budulinek/arduino-modbus-rtu-tcp-gateway/(threads)

Thread 2 (2021-04-10):

adapt project for stm32

jmcastillejo, 2021-04-10:
I would like to know if it is possible to adapt this project for the stm32f103 "bluepill" or similar

budulinek, 2021-04-10:
I do not have bluepill at the moment, so I can not test it.

It should be possible, but you will need to do some changes to the code. See https://github.com/budulinek/arduino-modbus-rtu-tcp-gateway#portability

Also, check the bluepill pinout for serial connections (for RS485) and SPI connections (for ethernet shield).

Closed 2021-04-12.

Thread 3 (2021-04-12):

warning compilation

jmcastillejo, 2021-04-12:
Warning compiler for mega2560:

arduino-modbus-rtu-tcp-gateway\04-webserver.ino:288:20: warning: invalid conversion from 'byte {aka unsigned char}' to 'action_type' [-fpermissive]
           action = (byte)atoi(strtok_r(NULL, "=", &sav2));

budulinek, 2021-04-12:
Yes, I know.

In order to minimize the code size (so that it can fit Nano), I did a dirty trick with atoi() while parsing the "Tools" form values (buttons):

https://github.com/budulinek/arduino-modbus-rtu-tcp-gateway/blob/51595a10fe23155318b2775a49f6ef0d00921b43/arduino-modbus-rtu-tcp-gateway/04-webserver.ino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

I think it is save to ignore the warning, because the form values are fully under our control and can only have values 1, 2 and 3.
see https://github.com/budulinek/arduino-modbus-rtu-tcp-gateway/blob/51595a10fe23155318b2775a49f6ef0d00921b43/arduino-modbus-rtu-tcp-gateway/05-pages.ino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

Also, see comments in code:
https://github.com/budulinek/arduino-modbus-rtu-tcp-gateway/blob/51595a10fe23155318b2775a49f6ef0d00921b43/arduino-modbus-rtu-tcp-gateway/04-webserver.ino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

budulinek, 2021-04-12:
That did the trick :-)

Closed 2021-04-12.

Thread 5 (2021-04-13):

timeout error

jmcastillejo, 2021-04-13:
I have managed to make the project work on an arduino mega 2560, but the master simulator throws me timeout error in alternate reads, one ok and another reading timeout error and so on. that could be happening?

great job

budulinek, 2021-04-13:
Which master simulator do you use?

Do you have errors on both Modbus TCP and Modbus UDP?

What is your connection timeout on master? What is your timeout on Arduino?

Thanks.

jmcastillejo, 2021-04-14:
I use de radzio master simulator http://en.radzio.dxp.pl/modbus-master-simulator/

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

This softaware not support modbus udp. In arduino timeout set to 1000ms, although with other configurations it still fails the same

budulinek, 2021-04-14:
Thanks. Yes, I can reproduce the error. Modbus UDP is OK, so the problem is in the way I use TCP sockets...

jmcastillejo, 2021-04-19:
Do you have any solution?

tdcbyte, 2021-05-24:
I confirm the issue, also tested with arduino mega. UDP works fine, when using TCP, after the first request, the response is good, but second request is timed out en not send to the serial slave. The the third request is ok, the forth is not answered and so on...
I hope this can be fixed, still this project is really nice!

fumpel, 2021-06-03:
I think, I'm running into the same problem... I'm using the QModMaster. Behaviour is little different though: After opening a TCP connection the first request works fine, all subsequent requests don't. Reopening the connection again gives one working request.

fumpel, 2021-06-04:
Had a look at the code...
Could it be, that this line:
[https://github.com/budulinek/arduino-modbus-rtu-tcp-gateway/blob/16246c5eff7095fcb870da9db0f55f82c50b81ea/arduino-modbus-rtu-tcp-gateway/02-modbus-tcp.ino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](client.stop())
is the issue? Isn't this closing the TCP Connection after every received packet? Then the TCP Modbus Master would have to reestablish the connection after every packet... simple Modbus Masters won't do that.

budulinek, 2021-06-05:
Essentially there are two ways how to handle sockets:

First aproach:
https://www.arduino.cc/en/Tutorial/LibraryExamples/WebServer
`EthernetClient client = server.available();`

Second approach:
https://www.arduino.cc/en/Tutorial/LibraryExamples/AdvancedChatServer
you declare before setup:
`EthernetClient clients[8];`
and the inside loop (or some nested function):
```
EthernetClient newClient = server.accept();
  if (newClient) {
    for (byte i=0; i < 8; i++) {
      if (!clients[i]) {
        clients[i] = newClient;
        break;
      }
    }
  }
```

Originally, I used the second approach and everything worked fine. Then I switched to the first approach (to save some code) and it broke the TCP connections. Sockets get closed and I do not even know whether it is because of my code or the library.

I was busy at work so did not have time to look at it.
@fumpel I do not think removing this client.stop(); solves the issue.

budulinek, 2021-06-06:
@fumpel
Oh man, you were right. Removing all instances of  client.stop() solved the issue.

https://github.com/budulinek/arduino-modbus-rtu-tcp-gateway/commit/574c3cc78f476bb6d9bc1779059331fc5668aac1

We do not need client.stop(), because the server.available() function should take care of this (it should close connection if the remote hos closes the connection).

If the problem reappears, let me know.

SuriyaStar123, 2021-12-20:
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

How to get off this error and write numbers in 0 and check with modscan

Closed 2021-06-06.

Thread 6 (2021-05-03):

Run this Gateway on a ESP8266

turti83, 2021-05-03:
I am new on github and dont know how to ask a questions like this way. Is this the right way?
This project is exactly what i was looking for. However, I would like to run it on an ESP8266. Is it possible without a lot of changes, or does it take a lot of effort to run it on the esp?
certainly the following line must be inserted:
#include <ESP8266WiFi.h>
and removed this:
#include <utility/w5100.h>

budulinek, 2021-06-06:
Sorry, but I do have no experience with ESP8266.
There is some code which is specific to Arduino (see https://github.com/budulinek/arduino-modbus-rtu-tcp-gateway#portability). So some modifications are needed.
Feel free to fork my repository and modify the code for ESP8266.

harihanv, 2021-07-14:
https://github.com/harihanv/esp32-modbus-gateway, trying to port on esp32

ayaser, 2021-12-27:
Nice to meet you. first congratulations for your contribution. I have several doubts, one of them is the same as the one made by Turti83, how to use these codes in ESP8266, and I clearly saw that your answer is that you have not developed it on this platform.
The other question I have is that there are several ino files in the folder, and the question I have is whether each of these can be loaded on the platform that one would like independently. That is, if I want the Slave to work in an Arduino (1), how do I load only the Slave, if I want the Master to work in the Arduino (2), how do I do it?
I have the problem because when compiling, it does it mostly the innocent. Please could you explain.

budulinek, 2021-12-27:
Hi ayaser,
the code was made for AVR Arduino. There is some AVR-specific codec (see Readme). Maybe, after removing / changing that piece of code, it would be possible to run it on ESP8266 or ESP32. But I do not know, I do not have ESP8266 or ESP32, so I can not test it.  You can try this port:
https://github.com/harihanv/esp32-modbus-gateway

The code is quite long, I have divided it into several ino files. You need all ino files in the folder to compile the code.

ayaser, 2021-12-27:
muchas gracias por tu respuesta.

Adrián Yaser

***@***.***
+56 9 6149 8858 <https://api.whatsapp.com/send?phone=+56961498858>

DVRSOLUTIONS
Servicios y Productos para su Seguridad
<https://api.whatsapp.com/send?phone=+56961498858>

El lun, 27 dic 2021 a la(s) 13:59, budulinek ***@***.***)
escribió:

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

budulinek, 2021-12-27:
BTW, @harihanv was able to run it on ESP32, but his code is obsolete - he did not fork from my repo but created new one  :-(

Please fork the repo and if you (or anyone else) is successful in porting to ESP32 / ESP8266, feel free to do a pull request. I would be happy to include it.

ayaser, 2021-12-27:
Thank you very much for your answer
The five programs are united in the first one, is correct what I say? those
are not 5 standalone programs.
Therefore, everything would be loaded on the arduino board and then through
the web I would choose which function it would fulfill.
what i said is correct?

El lun., 27 de diciembre de 2021 2:40 p. m., budulinek <
***@***.***> escribió:

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

harihanv, 2021-12-28:
hi,

 I am sorry for the late reply. I was trying to implement RTU to TCP modbus
gateway. This is more of packet translation
that was the reason i used the code available and ported to esp32.

From your description looks like you need modbus slave / master for your
implementation. We can either port libmodbus
or freemodbus to esp8266.

I will check on nodemcu and update.

Regards,
Harish

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

ayaser, 2021-12-28:
Sorry, my English is not the best, and I think I got a little lost in the
thread of the conversation, I don't know if all the emails were yours, or
if another person intervened commenting on ESP8266.

First of all, thanks again for your answer.
The project that you wrote is just what I need, that is why I attached a
file in pptx in case you want to modify it or rather correct it.
It is about implementing Modbus, a slave in which I can execute certain
programs, a Master which can give setting values to the Slave, and a
Gateway that allows me to send the parameters to Modbus and deliver its
results to the user, which could be both an operator like the manager.

I am an electronic engineer, I am not an expert in programming, and I am
trying to make a technology integration system, I do not intend to invent
anything, but to develop a system that I can implement to sell and earn
money.
I want to clarify this because I am not an expert in open systems, so I do
not know what is the scope of what I can expect from this type of
contribution, which I see as extraordinary. What I mean is that if your
time had a cost, I am not in a position to pay it now, but if the economic
result were advantageous, I would have no problem sharing it.

Using the translator, I can know if the phrase in English is correct, if
they express what I want to convey to you.
If you have any possibility of being able to do a chat (written), it would
be good if we could talk, logically if you have time.

I am in Chile, with time zone -3.

My cell phone is +56961498858.
Kind regards.

Adrián Yaser

***@***.***
+56 9 6149 8858 <https://api.whatsapp.com/send?phone=+56961498858>

DVRSOLUTIONS
Servicios y Productos para su Seguridad
<https://api.whatsapp.com/send?phone=+56961498858>

El mar, 28 dic 2021 a la(s) 01:26, harihanv ***@***.***)
escribió:

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

harihanv, 2021-12-28:
Request to attach the ppt again. I have taken code from the author who
replied previously; removed ethernet code and added wifi.

If you are looking it to work on esp8266, I need to check on serial port
availability.

Regards,
Harish

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

ayaser, 2021-12-28:
I apologize. I did not understand his answer.

Adrián Yaser

***@***.***
+56 9 6149 8858 <https://api.whatsapp.com/send?phone=+56961498858>

DVRSOLUTIONS
Servicios y Productos para su Seguridad
<https://api.whatsapp.com/send?phone=+56961498858>

El mar, 28 dic 2021 a la(s) 06:50, harihanv ***@***.***)
escribió:

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

harihanv, 2021-12-28:
Please share the ppt

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

Thread 7 (2021-09-01):

The connection to the Modbus master is broken after a few hours

dl9msr, 2021-09-01:
Hardware:
Arduino Mega 2560, W5500 lite, 1 RTU Slave 0x01
Modbus Mode : Modbus TCP/UDP

Modbus Master TCP/502, query interval 120s ,timeout 5s

The connection to the web interface TCP/80 also breaks off.
After pressing the reset button, the connection is re-established

budulinek, 2021-09-01:
Only TCP connections break down? UDP packets and ping still working?

At the moment I use Modbus UDP (without problems), but I will switch to Modbus TCP and try to reproduce.

dl9msr, 2021-09-02:
I have only TCP connections.

Ping also don’t work

I tried to use the library

ethernet2.h

utility/w5500.h

but I got compiler failer

best regards

Michael

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

budulinek, 2021-09-04:
So I have been using both Modbus UDP and Modbus TCP  (simultaneously) for 2 days, no problem with the connection.

Arduino Nano + W5500 (8 sockets) + RS485 module with HW flow control. Modbus UDP query interval 1s, Modbus TCP query interval 5s.

If you are willing to do further tests, here are my suggestions:

1. Stress test TCP connection.

Enable per socket diagnostics https://github.com/budulinek/arduino-modbus-rtu-tcp-gateway/blob/3a9afdfba7689f2c079b421252b8db301b681e2b/arduino-modbus-rtu-tcp-gateway/arduino-modbus-rtu-tcp-gatew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

Use https://packetsender.com/ to test TCP (or UDP) connections. If you send Modbus TCP message (with correctly formated header) to the gateway, you will get a response (either a message with Modbus data, or a message with a Modbus error). You can try for example HEX: 00 01 00 00 00 06 01 04 00 00 00 01

Try both TCP and UDP.

Then you can set "Resend delay" to some low value, such as 0.1s and start sending TCP data periodically. This is the stress test (DoS) to the gateway. If the "Resend delay" is low enough, all sockets available on your ethernet module will quickly fill (you can see the status of all sockets it in the status web page of the gateway) and you will get connection errors (in Packet Sender and maybe also your web browser). If you stop the stress test, Arduino should gradually free up some sockets and everything should get to normal.
If the TCP stress test is successful (= if Arduino correctly recovers sockets once you stop the stress test), you know that TCP socket allocation (and recovery) works correctly.

2. Disable Web UI.

You can try to disable parts of the code (functionality) within the sketch and see if the problem with Modbus TCP connection persists. As the first step, you can disable Web UI by commenting out these lines:

https://github.com/budulinek/arduino-modbus-rtu-tcp-gateway/blob/3a9afdfba7689f2c079b421252b8db301b681e2b/arduino-modbus-rtu-tcp-gateway/04-webserver.ino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
https://github.com/budulinek/arduino-modbus-rtu-tcp-gateway/blob/3a9afdfba7689f2c079b421252b8db301b681e2b/arduino-modbus-rtu-tcp-gateway/04-webserver.ino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
https://github.com/budulinek/arduino-modbus-rtu-tcp-gateway/blob/3a9afdfba7689f2c079b421252b8db301b681e2b/arduino-modbus-rtu-tcp-gateway/04-webserver.ino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

There is a lot of code responsible for the Web UI and I did found some bugs over there in the past. PLS let me know if disabling Web UI helped or not.

P.S. ethernet2.h won't compile since I use some functions which are only available in default ethernet.h library

dl9msr, 2021-09-05:
So I did the stress test and everything works as you wrote.

Now I disabled the Web UI by commenting out these lines:
`111 //      sendPage(client, 0xFF);                                 // Send "please wait" page

140  //    sendPage(client, reqPage);
141  //   else if (!strcmp(uri, "/favicon.ico"))     // a favicon
142  //     send204(client);                         // if you don't have a favicon, send 204
143 //    else                                       // if the page is unknown, HTTP response code 404
`
I will then come back with the result

dl9msr, 2021-09-07:
So I have been testing ModbusTCP for 2 days and have no problems with the connection.
WEb UI current status active all the time
Extra_Diag enabled
other Web UI commented out
Modbus/Master Settings for the test:
read interval 10s
timeout 10s

budulinek, 2021-09-07:
Thanks for debugging!

OK, so it seems that the bug is somewhere in 05-pages.ino

We also know that status page (i.e. reqPage == 1 ) works OK.

If you are willing to proceed here are my suggestions.

Reverse your previous comments you made in 04-webserver.ino, we will focus on 05-pages.ino

Comment out references to functions responsible for other pages:
https://github.com/budulinek/arduino-modbus-rtu-tcp-gateway/blob/3a9afdfba7689f2c079b421252b8db301b681e2b/arduino-modbus-rtu-tcp-gateway/05-pages.ino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
https://github.com/budulinek/arduino-modbus-rtu-tcp-gateway/blob/3a9afdfba7689f2c079b421252b8db301b681e2b/arduino-modbus-rtu-tcp-gateway/05-pages.ino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
https://github.com/budulinek/arduino-modbus-rtu-tcp-gateway/blob/3a9afdfba7689f2c079b421252b8db301b681e2b/arduino-modbus-rtu-tcp-gateway/05-pages.ino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
https://github.com/budulinek/arduino-modbus-rtu-tcp-gateway/blob/3a9afdfba7689f2c079b421252b8db301b681e2b/arduino-modbus-rtu-tcp-gateway/05-pages.ino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

You may also comment out the code responsible for autorefresh (lines 43-49)
  if (reqPage == 1 || reqPage == 0xFF) page.print(F(" http-equiv=refresh content=5"));
  if (reqPage == 0xFF) {
    page.print(F(";url=http://"));
    page.print((IPAddress)localConfig.ip);
    page.print(F(":"));
    page.print(localConfig.webPort);
  }

If there are no problems with connection, you can enable pages one after another in order to catch the bug.

Hmm, you know what? I have a suspicion that this line could be the cause of the bug:

https://github.com/budulinek/arduino-modbus-rtu-tcp-gateway/blob/3a9afdfba7689f2c079b421252b8db301b681e2b/arduino-modbus-rtu-tcp-gateway/05-pages.ino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

change it to

content.print((IPAddress)defaultConfig.ip);

defaultConfig.ip already is IPAddress type,  so we probably do not need to use the (IPAddress) cast. But see

https://github.com/budulinek/arduino-modbus-rtu-tcp-gateway/blob/3a9afdfba7689f2c079b421252b8db301b681e2b/arduino-modbus-rtu-tcp-gateway/05-pages.ino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

where I had to use the (IPAddress) cast. Do not know why, but without the cast, line 46 caused Arduino freezing.

dl9msr, 2021-09-08:
Thank you for response.
I started the test with the change in line 544

dl9msr, 2021-09-10:
That seems to be the bug.
The test has been running for 48 hours without any problems.
Many thanks for your help.

budulinek, 2021-09-10:
Great to hear that!

Thanks for hunting the bug!

Closed 2021-09-10.

Thread 10 (2021-11-15):

the last version doesn't work well

dl9msr, 2021-11-15:
Hello,
the last version v3.0 doesn't work well.
The connection freezes after a few minutes and I have to reset the Arduiono.
Troubleshooting from last issue didn't help
I'm back to version v2.3

Best regards
Michael

budulinek, 2021-11-15:
Hi,
thanks for your report.

My Arduino is fine at the moment. In version 3.0 I have increased webOutBufferSize from 64 bytes to 128 bytes in order to speed up web UI loading. I thought the step is safe... Could you PLS try to go back to 64 bytes and check whether it helps?

https://github.com/budulinek/arduino-modbus-rtu-tcp-gateway/blob/ac497050e0fdd2a4397ac155dacb7308a479f9c6/arduino-modbus-rtu-tcp-gateway/05-pages.ino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

dl9msr, 2021-11-15:
Hi,

thank you for your prompt reply. I have changed to 64byte.
I'll get back to you tomorrow

Good night.

Michael

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

dl9msr, 2021-11-16:
Hello,
I think the problem is my Arduino Mega 2560 on the test board and not your sketch.  I have to take a closer look at that.

I loaded the sketch in the production system with the Arduino Mega 2560 R3 pro mini and it works fine there.

Thanks for your support

budulinek, 2021-11-16:
OK.

Closed 2021-11-16.

Thread 11 (2021-11-23):

Modbus RTU Slave ID in Modbus TCP/UDP not function

lilisugeng, 2021-11-23:
When using Modbus TCP/UDP the scanned modbus RTU Slave ID may not be stored permanently, causing the master to fail to connect.

budulinek, 2021-11-23:
This is a feature (of all Modbus Gateways), not a bug. It is up to the master to remember the correct slave ID. It is also up to the master to send correctly formated Modbus TCP message (which contains slave ID).

Does the "Scan" button find your RTU slave? It means that RTU slave sent a response to a test command sent by the gateway. It means that your RTU settings are correct.
Does RTU slave disappear from the "Current Status" page once you connect your master to the gateway? It means that:

- gateway accepted your Modbus TCP message from the master and forwarded it to the RS485 line
- RTU slave did not respond (maybe because the master used wrong slave ID) or responded with an error

PLS check the Modbus TCP message sent by the master.

lilisugeng, 2021-11-23:
The scan button finds the Slave RTU, in this case it finds 0x01 OK, that's also the Slave ID I set on the master.
I'm using a kepware OPC server for this test and I'm using a Schneider PM800 Energy Meter.
The gateway works fine when I use Modbus over TCP, with the same Slave ID setting, but not for Modbus TCP.  Is there anything I should pay more attention to? Thanks

lilisugeng, 2021-11-23:
Sory I think I did wrong in my kepware setup, I use modbus scanner it is working fine also when I use Modbus TCP.
Sorry again for my foolness.
Thanks so much,  the program you have made is realy awsome.  Thank you.

budulinek, 2021-11-23:
Hi, I am glad to hear that everything works :-) Be careful, Modbus TCP and Modbus RTU over TCP are two different things.
Have a nice day!

Closed 2021-11-23.

Thread 16 (2022-05-08):

Esp32 version

maufc, 2022-05-08:
Hi
I am trying to make this work on esp32. There are some fork version for esp32 but no one works, at least for esp32 dev board.
Would it be so complicated to adapt this to esp8266/esp32?
I think the memory limits on Arduino borads will be overcome.
The main problem seems to be in ArduinoRS485.h with SERIAL_PORT_HARDWARE variable definition.
Thanks!

hopfi2k, 2022-05-08:
Same here. Maybe https://github.com/plerup/espsoftwareserial/ is the way?
Thanks

budulinek, 2022-05-08:
I do not use ArduinoRS485.h (too big, not needed)!!!! I use Arduino HW serial for the communication with the RS485 module. Since ESP32 also has HW serial ports, modifying my gateway for ESP32 should be easy. I have no experience with ESP32, but I think all you need to do is:

1. replace the Ethernet.h with Wifi.h library and adjust the code accordingly (some functions may be missing in Wifi.h library)
2. use HW serial port on ESP32 (see https://circuits4you.com/2018/12/31/esp32-hardware-serial2-example/ )
3. find an alternative to these Arduino-specific libraries and functions:

https://github.com/budulinek/arduino-modbus-rtu-tcp-gateway/blob/5ee77b5b54f74b51e5f2c49246ac2ff60f4e7cb6/arduino-modbus-rtu-tcp-gateway/arduino-modbus-rtu-tcp-gatew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

https://github.com/budulinek/arduino-modbus-rtu-tcp-gateway/blob/5ee77b5b54f74b51e5f2c49246ac2ff60f4e7cb6/arduino-modbus-rtu-tcp-gateway/01-interfaces.ino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

https://github.com/budulinek/arduino-modbus-rtu-tcp-gateway/blob/5ee77b5b54f74b51e5f2c49246ac2ff60f4e7cb6/arduino-modbus-rtu-tcp-gateway/01-interfaces.ino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

I use these functions for generating random MAC and for reseting Arduino via Web UI. These are not core functions, you can easily modify the code to use static MAC and drop the function for reseting Arduino....

I know there is a ESP32 port here: https://github.com/harihanv/esp32-modbus-gateway
But it takes the wrong approach by using the ArduinoRS485.h library. As I have already said, forget about ArduinoRS485.h and use HW serial on your ESP32!

Once you have it running, let me know (or do a pull-request) and I would be happy to adjust my code to make it ESP32 compatible.

zivillian, 2022-06-12:
I've started a port, but it's still work in progress. It compiles, the web ui works (sometimes) but there are still many things to to. The current state is available at https://github.com/zivillian/arduino-modbus-rtu-tcp-gateway/tree/esp32

maufc, 2022-06-12:
Looks great!
I'll try this week and let you know!

zivillian, 2022-06-14:
I have to admit, that I gave up and started from scratch with ESP32 libraries. It's far from finished and there's no usable webinterface yet, but the modbus RTU/TCP stuff is already working. If anyone is interested and want's to help - my code is available at https://github.com/zivillian/esp32-modbus-gateway

zivillian, 2022-06-17:
It may not (yet) have all features, but I think I've reached the point where it's usable - if anyone is interested, there is also prebuilt binary to try out.

sefaguntepe, 2023-02-09:
Hello, I want to try the codes. Can you share the file for Arduino IDE?

sefaguntepe, 2023-02-10:
> It may not (yet) have all features, but I think I've reached the point where it's usable - if anyone is interested, there is also prebuilt binary to try out.

Hello, I want to try the codes. Can you share the file for Arduino IDE?

zivillian, 2023-02-10:
@sefaguntepe you can find the code at https://github.com/zivillian/esp32-modbus-gateway There is no file for Arduino IDE, because it's a platformio project. If you don't want to compile it yourself, you can try the binary from the release.

chuc2rk, 2024-08-05:
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

How about edit run on esp32 with W5500?
Thanks!

Thread 17 (2022-05-18):

exceeds available space in board in arduino nano

lilisugeng, 2022-05-18:
Dear Budulinek
I'm failed to build this project with arduino nano and its W5500 ethernet shield (RobotDyn). When I try to verify the program there is a message saying  exceeds available space in board.
But I thing you sucsess with the same hardware.  Please let me know if I did wrong.

Thanks

KjellVerb, 2022-05-21:
Probably due to some library updates... You can comment out the parts that generate a random MAC address and assign a static one, you'll be at 99%.

budulinek, 2022-05-21:
> Probably due to some library updates... You can comment out the parts that generate a random MAC address and assign a static one, you'll be at 99%.

Most probably (did not check yet). On Nano, there were just few bytes left. A library update may add few bytes, causing the issue you mention.

As suggested, try to comment out some code you do not need (random MAC, or some code in the webserver).

KjellVerb, 2022-05-21:
Yeah I started testing with the gateway on a nano yesterday (thanks for sharing your work btw!) and had the same issue, I can confirm that fixed Mac gets you below the threshold.

I'm now trying to get fixed RS485 settings with DHCP enabled because that fits my usecase better. Will fork if it works.

budulinek, 2022-05-21:
DHCP enabled on Nano? As far as I remember, DHCP enabled (dynamic IP) takes a lot of memory... Would require some drastic cuts to the code.

KjellVerb, 2022-05-21:
I'm OK with removing the entire webserver (drastic cuts indeed), I only need a static config with DHCP so that I can assign the IP address from my IOT router.

FYI: removing the webserver and enabling DHCP gets me to 74%, re-enabling random MAC address to 75%

budulinek, 2022-06-04:
Wow, some library got really hungry :-(   A library update (probably StreamLib) eating additional 200 bytes of precious flash....

I did my best to reduce the footprint of the program, I am at the end of my abilities.....

- Do you guys have any suggestions for further code optimisation?
- Any suggestions for which feature to remove from the default version of the sketch?

budulinek, 2022-06-04:
OK, I have removed ethernet data counter feature on the status page. If you need ethernet data counter, #define ENABLE_EXTRA_DIAG.
Now the program fits on Arduino Nano (tested 4.6.2022, Arduino IDE 1.8.19).

Closed 2022-06-04.

Thread 19 (2022-09-23):

Compiling Error

Honk815, 2022-09-23:
Hi budulinek,

great work. So I have an issue that I cannot solve. Maybe there is a library missing, but which? Error Code from Arduino IDE is attached. Thank you very much.

Nico
[error.txt](https://github.com/budulinek/arduino-modbus-rtu-tcp-gateway/files/9636570/error.txt)

budulinek, 2022-09-25:
It seems you did not properly download the INO files. Go to the main page https://github.com/budulinek/arduino-modbus-rtu-tcp-gateway
Code > Download ZIP

Unzip and open arduino-modbus-rtu-tcp-gateway.ino in Arduino IDE. Arduino IDE will automatically recognize other INO files (you will see them in separate tabs). Compile, upload and have fun!

Honk815, 2022-09-27:
Thank you very much, this solved the problems. I have downloaded the recommendet zip file.This is not ne reduced Code for nano, isn't it? I have got an error while compiling. "Program is too big for arduino nano" something like that. Thanks for help 😊
-------- Ursprüngliche Nachricht --------Von: budulinek ***@***.***> Datum: 25.09.22  23:34  (GMT+01:00) An: budulinek/arduino-modbus-rtu-tcp-gateway ***@***.***> Cc: Honk815 ***@***.***>, Author ***@***.***> Betreff: Re: [budulinek/arduino-modbus-rtu-tcp-gateway] Compiling Error (Issue #19)
It seems you did not properly download the INO files. Go to the main page https://github.com/budulinek/arduino-modbus-rtu-tcp-gateway
Code > Download ZIP
Unzip and open arduino-modbus-rtu-tcp-gateway.ino in Arduino IDE. Arduino IDE will automatically recognize other INO files (you will see them in separate tabs). Compile, upload and have fun!

—Reply to this email directly, view it on GitHub, or unsubscribe.You are receiving this because you authored the thread.Message ID: ***@***.***>

budulinek, 2022-09-28:
You are right, program too big. There was an update to Ethernet library in July and the library got bigger.

I will try to reduce the size of the code, but it may take me some time.

Honk815, 2022-09-29:
Thank very much! So I'am waiting for :-)
Like to reed out my PV inverter via modbus :)

budulinek, 2023-01-05:
Fixed!

Closed 2023-01-05.

Thread 21 (2023-02-27):

"Unknown board"

Hypercubo, 2023-02-27:
Hello, I have a problem with the code does not recognize the board. The model I have is the "atmega328p Xplained mini".

Error is:
287 #error "Unknown board"

Can anyone tellme, how fix it?

My configuration is:
Board: atmega328p Xplained mini (the hardware is same to serie NANO)
Ethernet: ENC28J60 (NANO Ethernet Shield v1.0 "Deek-Robot")
Modbus: MAX485

best Regards.

budulinek, 2023-02-27:
Sorry, ENC28J60 Ethernet chip is not supported. This is a very primitive chip, requires too much code to operate.

Please look for W5100, W5200 or W5500 Ethernet chips.

Hypercubo, 2023-02-27:
Very appreciate your answer, I'm going to follow your suggestion and I'm going to buy one of the chips you've indicated.
But i think the problem is other, because the error is come when i compile the software.

:(

budulinek, 2023-02-27:
It is not an error, only a warning generated here:

https://github.com/budulinek/arduino-modbus-rtu-tcp-gateway/blob/e9b04e0782aadbde82b311b4e275445ba4986fb9/arduino-modbus-rtu-tcp-gateway/01-interfaces.ino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

The board you use is unknown, but the code will still compile.

Hypercubo, 2023-02-27:
Ok, ty, i´m try it again when is arrived new ethernet shield.

budulinek, 2023-02-27:
You were right. The #error directive prevented compilation.
Fixed https://github.com/budulinek/arduino-modbus-rtu-tcp-gateway/commit/4bdf86b5f0abef4667fef429939ebc155f7168a5

Closed 2023-02-27.

Thread 24 (2023-04-19):

Trouble porting to STM32 Arduino

completehvac, 2023-04-19:
I am having some trouble getting this to work on STM32, have you tried this? I am using W5500 and get odd results when using the library functions such as W5100.readSnPORT(dataAvailable) this function.

If I assign it to a variable like this
uint8_t SnPORT = W5100.readSnPORT(dataAvailable); and then compare
if (SnPORT == 80) it works, but

if (W5100.readSnPORT(dataAvailable) == 80) gives incorrect results.

I think it might be a timing issue, but I cannot get it to work! I have tried a basic webserver with the hardware configuration and it works without issue. The only changes from your latest version is that I remove the generateuniqueID and hard code a mac address for testing.

budulinek, 2023-04-19:
Hi,
thanks for testing STM32 + W5500! I have not tried it myself.

My suspicion is wrong data type (cast). As far as I remember, W5100.readSnPORT() is uint16_t. Maybe `if (W5100.readSnPORT(dataAvailable) == 80)` fails because you are comparing different data types? Try to force uint16_t on the constant? Maybe `uint16_t(80)`?

if you use uint16_t in:
`uint16_t SnPORT = W5100.readSnPORT(dataAvailable);` and then compare
`if (SnPORT == 80)`, will it still work??

Also, at the moment I use `byte` and `unsigned int` data types. It would be a good idea to replace them with `uint8_t` and `uint16_t`.

completehvac, 2023-04-19:
Thanks for your reply, I tested and that want the issue, the cause was that I was reading the client port which for some reason reset the SnPORT to 0x00. That part now works, now I have other issues to find..
Thanks for your help.

Closed 2023-08-22.

Thread 32 (2023-12-12):

Arduino OPTA port

patkepa, 2023-12-12:
Hello!
I'm interested in porting this project to the Arduino OPTA(STM32H747XI)
Are there any suggestions  in regards to replacing the Atmega based code of this project, for STM32?

Thanks!

budulinek, 2024-01-14:
What ethernet chip is used in Arduino OPTA? Which ethernet chip do you want to use with STM32?

The code is tailor-made for the Wiznet W5100/W5200/W5500 ethernet chip. It would be very difficult to "port" the code to different ethernet chip.

papercodeIN, 2024-06-03:
Hi Creator,

Could you guide me how to implement this in wiznet w5100s-evb-pico (Raspberry Pi Pico) ?

budulinek, 2024-06-03:
> Hi Creator,
>
> Could you guide me how to implement this in wiznet w5100s-evb-pico (Raspberry Pi Pico) ?

I have no idea on how to port it to RPi. Some functions and libraries used by this project are specific to W5X00 ethernet chips (Ethernet.h library), some functions I use are specific to ATmega chips (random number generator, reset function, also probably the Serial library...).

Disclosure: I am a 100% hobbyist coder with no formal coding education. I made this gateway for fun and for my self-education. A kind of challenge - what else can I fit into a very limited flash and RAM resources of the ATmega chip. I did not and do not have an intention to port this project to bigger and more powerful platforms.

Closed 2024-11-05.

Thread 33 (2024-07-25):

Ethernet Shield 2 isn't operate

LiquidOcelot29, 2024-07-25:
Hello everyone,

I want to try this project on my Arduino Uno R3 with an Ethernet Shield 2 (W5500 chip). I'm using newest Arduino IDE (2.3.2 version) and libraries: Ethernet (2.0.2), CircularBuffer (1.4.0) and StreamLib (1.4.0) up to date.
Compiling and uploading the sketch to Arduino was successful, without any errors, Tx diode blinking at some time, so I guess program is running.
Unfournately I cannot reach web server, Modbus Poll can't connect and ping 192.168.1.254 adress ends with failure.
I reject that Arduino board and/or Ethernet Shield might be broken, because I uploaded Ethernet->Webserver, then I was able to ping Arduino and succesfully open website (192.168.1.177 as in sketch).

Sorry for my poor description, but that's all what I can do and if is missing something I'm gonna fill that.

Any advice what is could be and how to solve it?

LiquidOcelot29, 2024-07-26:
Okay, I don't know what the heck is going on, but I decided to try 6.0 version and it was working fine... o.O
Then I tried each successive version of the releases and also works well, even the latest (7.3). So I guess that this issue is to close

Closed 2024-07-26.

Thread 34 (2024-11-01):

TCP to RTU gateway

vitucciog, 2024-11-01:
Hi,
I have exactly the opposite need, that is to connect a Modbus TCP slave to a Modbus RTU master. Any possibility to implement it? Or are you aware of project with Arduino or ESP8266 or ESP32 that already do it?

Thanks

budulinek, 2024-11-05:
No, it is not possible. This project runs on Arduino and there is no place left in the memory to implement this functionality.
 I am not aware of any ESP project but I know there are commercially available bi-directional Modbus converters. For example this one:
https://en.papouch.com/tcp2rtu-modbus-tcp-to-rtu-ascii-converter-p4620/

Closed 2024-11-05.

Thread 35 (2024-12-03):

timeout but slave respond

pmolke, 2024-12-03:
I get an error code 11 when I send a request to the slave.
But with a sniffer I see that the device responds correctly

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

budulinek, 2024-12-03:
Did you try to send your Modbus RTU request through the built-in web interface? What was the result? Ideally, post here the request message, response message and any results you get in the "Modbus Statistics" in web UI.

What was the result you sniffed on the RS485 line? Looking at your picture, the result was 00 e9 00 02 ? That is weird. That is not a correct Modbus message (for a response).

pmolke, 2024-12-04:
![Uploading image.jpg…]()

pmolke, 2024-12-06:
No idea?

budulinek, 2024-12-06:
My suspicion is some HW issue rather than a bug in SW. What is your baud rate? Do you use RS485-TTL module with HW flow control? Maybe the response came too fast and the module did not have enough time to switch the flow 🤷

pmolke, 2024-12-06:
Correct. The sniffer is passiv.

I also suspect that the answer comes too quickly. Do you know how quickly the Modbus module needs to switch automatically? So far I've only had modules that had to be switched manually using a PIN.

pmolke, 2024-12-06:
Baud is 9600

budulinek, 2024-12-06:
I did some tests some time ago but I do not remember the exact result. Can also vary depending on the module you use.

I had to introduce Inter-frame delay (far higher than Modbus specs) in order to deal with the switching time of the RS485 modules. The Inter-frame delay (see RTU settings) is a delay between gateway receiving response via RS485 and sending new request (stored in buffer). If the delay was set too low, the request (which was waiting to be sent in the buffer) was sent (via TTL to the module) too early, before the module could switch the flow.

I have 150 ms as default Interframe delay. This value was safe (= high enough) for the RS485 module I use.

budulinek, 2024-12-06:
Your Modbus slave responds in 15 ms. That is very fast response. Maybe even faster than it should be according to Modbus specs. I do not remember what the minimum Interframe delay should be at baud 9600...

pmolke, 2024-12-06:
I have now added a delay of 300 ms to the slave before it responds.

Unfortunately no success.
Unfortunately I don't know why this doesn't work. I need to test another slave device to rule out a problem with my gateway

budulinek, 2024-12-06:
The Interframe delay setting only regulates delay between response received by the gateway and new request sent by the gateway. Changing the setting will not solve your issue.

I think you either have to use RS485-TTL module with manual switching or try to find some (really) fast module with automatic switching.

pmolke, 2024-12-06:
I have now connected another RS485 module and used PIN6.

Now it works as desired.
It's a shame, I would have preferred the other module.

Thanks for the great software.

Would it be time-consuming to add password protection to the web interface?

budulinek, 2024-12-06:
> I need to test another slave device to rule out a problem with my gateway

Good idea. PLS let me know if you have success with other device.

... and one more idea. Is it possible to lower baud on your slave? Down to let's say 300? Maybe by setting the slave to lower baud you can force the slave to extend the response time (=Interframe delay on the slave). According to Modbus specs, the minimum Interframe delay depends on baud.

pmolke, 2024-12-06:
I still have the problem that sometimes all connections are disconnected and I have to restart the Arduino to get it to work again.

budulinek, 2024-12-06:
Do you have external power source?

pmolke, 2024-12-06:
No, the Board is connected with my Laptop over USB

You mean under-voltage is the problem ?

budulinek, 2024-12-06:
The problem with lost connection is caused by power / reset issues of the Ethernet module. I will update readme with possible solution. Hopefully on Sunday.

budulinek, 2024-12-06:
> No, the Board is connected with my Laptop over USB
>
> You mean under-voltage is the problem ?

Probably not. USB should provide enough current (with stable voltage) for Arduino, Ethernet module and the RS485 module.

budulinek, 2024-12-15:
> The problem with lost connection is caused by power / reset issues of the Ethernet module. I will update readme with possible solution. Hopefully on Sunday.

Please check https://github.com/budulinek/arduino-modbus-rtu-tcp-gateway/blob/master/Ethernet_SW_Reset.md

And let me know if it works for you.

pj-r, 2025-03-25:
I had the timeouts also with node red and node-red-contrib-modbus but changing the TCP Type from DEFAULT to RTU buffered resolved the issue. Also UDP did work correctly.
