budulinek/arduino-modbus-rtu-tcp-gateway/arduino-modbus-rtu-tcp-gateway/01-interfaces.ino

/**************************************************************************/
/*!
  @brief Initiates HW serial interface which we use for the RS485 line.
*/
/**************************************************************************/
void startSerial() {
  mySerial.begin((data.config.baud * 100UL), data.config.serialConfig);
#ifdef RS485_CONTROL_PIN
  pinMode(RS485_CONTROL_PIN, OUTPUT);
  digitalWrite(RS485_CONTROL_PIN, RS485_RECEIVE);  // Init Transceiver
#endif                                             /* RS485_CONTROL_PIN */
}

// Number of bits per character (11 in default Modbus RTU settings)
byte bitsPerChar() {
  byte bits =
    1 +                                                         // start bit
    (((data.config.serialConfig & 0x06) >> 1) + 5) +            // data bits
    (((data.config.serialConfig & 0x08) >> 3) + 1);             // stop bits
  if (((data.config.serialConfig & 0x30) >> 4) > 1) bits += 1;  // parity bit (if present)
  return bits;
}

// Character timeout in micros
uint32_t charTimeOut() {
  if (data.config.baud <= 192) {
    return (15000UL * bitsPerChar()) / data.config.baud;  // inter-character time-out should be 1,5T
  } else {
    return 750;
  }
}

// Minimum frame delay in micros
uint32_t frameDelay() {
  if (data.config.baud <= 192) {
    return (35000UL * bitsPerChar()) / data.config.baud;  // inter-frame delay should be 3,5T
  } else {
    return 1750;  // 1750 μs
  }
}

/**************************************************************************/
/*!
  @brief Initiates ethernet interface, if DHCP enabled, gets IP from DHCP,
  starts all servers (UDP, web server).
*/
/**************************************************************************/
void startEthernet() {
#ifdef ETH_RESET_PIN
  pinMode(ETH_RESET_PIN, OUTPUT);
  digitalWrite(ETH_RESET_PIN, LOW);
  delay(25);
  digitalWrite(ETH_RESET_PIN, HIGH);
  delay(ETH_RESET_DELAY);
#endif

#ifdef ENABLE_DHCP
  dhcpSuccess = false;
  if (data.config.enableDhcp) {
    dhcpSuccess = Ethernet.begin(data.mac);
  }
  if (!dhcpSuccess) {
    Ethernet.begin(data.mac, data.config.ip, data.config.dns, data.config.gateway, data.config.subnet);
  }
#else  /* ENABLE_DHCP */
  Ethernet.begin(data.mac, data.config.ip, {}, data.config.gateway, data.config.subnet);  // No DNS
#endif /* ENABLE_DHCP */

  W5100.setRetransmissionTime(TCP_RETRANSMISSION_TIMEOUT);
  W5100.setRetransmissionCount(TCP_RETRANSMISSION_COUNT);
  modbusServer = EthernetServer(data.config.tcpPort);
  webServer = EthernetServer(data.config.webPort);
  Udp.begin(data.config.udpPort);
  modbusServer.begin();
  webServer.begin();
#if MAX_SOCK_NUM > 4
  if (W5100.getChip() == 51) maxSockNum = 4;  // W5100 chip never supports more than 4 sockets
#endif
}

/**************************************************************************/
/*!
  @brief Resets Arduino (works only on AVR chips).
*/
/**************************************************************************/
void (*resetFunc)(void) = 0;  //declare reset function at address 0

/**************************************************************************/
/*!
  @brief Checks SPI connection to the W5X00 chip.
*/
/**************************************************************************/
void checkEthernet() {
  static byte attempts = 0;
  IPAddress tempIP = Ethernet.localIP();
  if (tempIP[0] == 0) {
    attempts++;
    if (attempts >= 3) {
      resetFunc();
    }
  } else {
    attempts = 0;
  }
  checkEthTimer.sleep(CHECK_ETH_INTERVAL);
}

/**************************************************************************/
/*!
  @brief Maintains uptime in case of millis() overflow.
*/
/**************************************************************************/
#ifdef ENABLE_EXTENDED_WEBUI
void maintainUptime() {
  uint32_t milliseconds = millis();
  if (last_milliseconds > milliseconds) {
    //in case of millis() overflow, store existing passed seconds
    remaining_seconds = seconds;
  }
  //store last millis(), so that we can detect on the next call
  //if there is a millis() overflow ( millis() returns 0 )
  last_milliseconds = milliseconds;
  //In case of overflow, the "remaining_seconds" variable contains seconds counted before the overflow.
  //We add the "remaining_seconds", so that we can continue measuring the time passed from the last boot of the device.
  seconds = (milliseconds / 1000) + remaining_seconds;
}
#endif /* ENABLE_EXTENDED_WEBUI */

/**************************************************************************/
/*!
  @brief Synchronizes roll-over of data counters to zero.
*/
/**************************************************************************/
bool rollover() {
  const uint32_t ROLLOVER = 0xFFFFFF00;
  for (byte i = 0; i < ERROR_LAST; i++) {
    if (data.errorCnt[i] > ROLLOVER) {
      return true;
    }
  }
#ifdef ENABLE_EXTENDED_WEBUI
  if (seconds > ROLLOVER) {
    return true;
  }
  for (byte i = 0; i < DATA_LAST; i++) {
    if (data.rtuCnt[i] > ROLLOVER || data.ethCnt[i] > ROLLOVER) {
      return true;
    }
  }
#endif /* ENABLE_EXTENDED_WEBUI */
  return false;
}

/**************************************************************************/
/*!
  @brief Resets error stats, RTU counter and ethernet data counter.
*/
/**************************************************************************/
void resetStats() {
  memset(data.errorCnt, 0, sizeof(data.errorCnt));
#ifdef ENABLE_EXTENDED_WEBUI
  memset(data.rtuCnt, 0, sizeof(data.rtuCnt));
  memset(data.ethCnt, 0, sizeof(data.ethCnt));
  remaining_seconds = -(millis() / 1000);
#endif /* ENABLE_EXTENDED_WEBUI */
}

/**************************************************************************/
/*!
  @brief Generate random MAC using pseudo random generator,
  bytes 0, 1 and 2 are static (MAC_START), bytes 3, 4 and 5 are generated randomly
*/
/**************************************************************************/
void generateMac() {
  // Marsaglia algorithm from https://github.com/RobTillaart/randomHelpers
  seed1 = 36969L * (seed1 & 65535L) + (seed1 >> 16);
  seed2 = 18000L * (seed2 & 65535L) + (seed2 >> 16);
  uint32_t randomBuffer = (seed1 << 16) + seed2; /* 32-bit random */
  memcpy(data.mac, MAC_START, 3);                // set first 3 bytes
  for (byte i = 0; i < 3; i++) {
    data.mac[i + 3] = randomBuffer & 0xFF;  // random last 3 bytes
    randomBuffer >>= 8;
  }
}

/**************************************************************************/
/*!
  @brief Write (update) data to Arduino EEPROM.
*/
/**************************************************************************/
void updateEeprom() {
  eepromTimer.sleep(EEPROM_INTERVAL * 60UL * 60UL * 1000UL);  // EEPROM_INTERVAL is in hours, sleep is in milliseconds!
  data.eepromWrites++;                                        // we assume that at least some bytes are written to EEPROM during EEPROM.update or EEPROM.put
  EEPROM.put(DATA_START, data);
}


uint32_t lastSocketUse[MAX_SOCK_NUM];
byte socketInQueue[MAX_SOCK_NUM];
/**************************************************************************/
/*!
  @brief Closes sockets which are waiting to be closed or which refuse to close,
  forwards sockets with data available for further processing by the webserver,
  disconnects (closes) sockets which are too old (idle for too long), opens
  new sockets if needed (and if available).
  From https://github.com/SapientHetero/Ethernet/blob/master/src/socket.cpp
*/
/**************************************************************************/
void manageSockets() {
  uint32_t maxAge = 0;         // the 'age' of the socket in a 'disconnectable' state that was last used the longest time ago
  byte oldest = MAX_SOCK_NUM;  // the socket number of the 'oldest' disconnectable socket
  byte modbusListening = MAX_SOCK_NUM;
  byte webListening = MAX_SOCK_NUM;
  byte dataAvailable = MAX_SOCK_NUM;
  byte socketsAvailable = 0;
  SPI.beginTransaction(SPI_ETHERNET_SETTINGS);  // begin SPI transaction
  // look at all the hardware sockets, record and take action based on current states
  for (byte s = 0; s < maxSockNum; s++) {            // for each hardware socket ...
    byte status = W5100.readSnSR(s);                 //  get socket status...
    uint32_t sockAge = millis() - lastSocketUse[s];  // age of the current socket
    if (socketInQueue[s] > 0) {
      lastSocketUse[s] = millis();
      continue;  // do not close Modbus TCP sockets currently processed (in queue)
    }

    switch (status) {
      case SnSR::CLOSED:
        {
          socketsAvailable++;
        }
        break;
      case SnSR::LISTEN:
      case SnSR::SYNRECV:
        {
          lastSocketUse[s] = millis();
          if (W5100.readSnPORT(s) == data.config.webPort) {
            webListening = s;
          } else {
            modbusListening = s;
          }
        }
        break;
      case SnSR::FIN_WAIT:
      case SnSR::CLOSING:
      case SnSR::TIME_WAIT:
      case SnSR::LAST_ACK:
        {
          socketsAvailable++;                  // socket will be available soon
          if (sockAge > TCP_DISCON_TIMEOUT) {  //     if it's been more than TCP_CLIENT_DISCON_TIMEOUT since disconnect command was sent...
            W5100.execCmdSn(s, Sock_CLOSE);    //	    send CLOSE command...
            lastSocketUse[s] = millis();       //       and record time at which it was sent so we don't do it repeatedly.
          }
        }
        break;
      case SnSR::ESTABLISHED:
      case SnSR::CLOSE_WAIT:
        {
          if (EthernetClient(s).available() > 0) {
            dataAvailable = s;
            lastSocketUse[s] = millis();
          } else {
            // remote host closed connection, our end still open
            if (status == SnSR::CLOSE_WAIT) {
              socketsAvailable++;               // socket will be available soon
              W5100.execCmdSn(s, Sock_DISCON);  //  send DISCON command...
              lastSocketUse[s] = millis();      //   record time at which it was sent...
                                                // status becomes LAST_ACK for short time
            } else if (((W5100.readSnPORT(s) == data.config.webPort && sockAge > WEB_IDLE_TIMEOUT)
                        || (W5100.readSnPORT(s) == data.config.tcpPort && sockAge > (data.config.tcpTimeout * 1000UL)))
                       && sockAge > maxAge) {
              oldest = s;        //     record the socket number...
              maxAge = sockAge;  //      and make its age the new max age.
            }
          }
        }
        break;
      default:
        break;
    }
  }

  if (dataAvailable != MAX_SOCK_NUM) {
    EthernetClient client = EthernetClient(dataAvailable);
    if (W5100.readSnPORT(dataAvailable) == data.config.webPort) {
      recvWeb(client);
    } else {
      recvTcp(client);
    }
  }

  if (modbusListening == MAX_SOCK_NUM) {
    modbusServer.begin();
  } else if (webListening == MAX_SOCK_NUM) {
    webServer.begin();
  }

  // If needed, disconnect socket that's been idle (ESTABLISHED without data recieved) the longest
  if (oldest != MAX_SOCK_NUM && socketsAvailable == 0 && (webListening == MAX_SOCK_NUM || modbusListening == MAX_SOCK_NUM)) {
    disconSocket(oldest);
  }

  SPI.endTransaction();  // Serves to o release the bus for other devices to access it. Since the ethernet chip is the only device
  // we do not need SPI.beginTransaction(SPI_ETHERNET_SETTINGS) or SPI.endTransaction() ??
}

/**************************************************************************/
/*!
  @brief Disconnect or close a socket.
  @param s Socket number.
*/
/**************************************************************************/
void disconSocket(byte s) {
  if (W5100.readSnSR(s) == SnSR::ESTABLISHED) {
    W5100.execCmdSn(s, Sock_DISCON);  // Sock_DISCON does not close LISTEN sockets
    lastSocketUse[s] = millis();      //   record time at which it was sent...
  } else {
    W5100.execCmdSn(s, Sock_CLOSE);  //  send DISCON command...
  }
}


/**************************************************************************/
/*!
  @brief Seed pseudorandom generator using  watch dog timer interrupt (works only on AVR).
  See https://sites.google.com/site/astudyofentropy/project-definition/timer-jitter-entropy-sources/entropy-library/arduino-random-seed
*/
/**************************************************************************/
void CreateTrulyRandomSeed() {
  seed1 = 0;
  nrot = 32;  // Must be at least 4, but more increased the uniformity of the produced seeds entropy.
  // The following five lines of code turn on the watch dog timer interrupt to create
  // the seed value
  cli();
  MCUSR = 0;
  _WD_CONTROL_REG |= (1 << _WD_CHANGE_BIT) | (1 << WDE);
  _WD_CONTROL_REG = (1 << WDIE);
  sei();
  while (nrot > 0)
    ;  // wait here until seed is created
  // The following five lines turn off the watch dog timer interrupt
  cli();
  MCUSR = 0;
  _WD_CONTROL_REG |= (1 << _WD_CHANGE_BIT) | (0 << WDE);
  _WD_CONTROL_REG = (0 << WDIE);
  sei();
}

ISR(WDT_vect) {
  nrot--;
  seed1 = seed1 << 8;
  seed1 = seed1 ^ TCNT1L;
}

// Preprocessor code for identifying microcontroller board
#if defined(TEENSYDUINO)
//  --------------- Teensy -----------------
#if defined(__AVR_ATmega32U4__)
#define BOARD F("Teensy 2.0")
#elif defined(__AVR_AT90USB1286__)
#define BOARD F("Teensy++ 2.0")
#elif defined(__MK20DX128__)
#define BOARD F("Teensy 3.0")
#elif defined(__MK20DX256__)
#define BOARD F("Teensy 3.2")  // and Teensy 3.1 (obsolete)
#elif defined(__MKL26Z64__)
#define BOARD F("Teensy LC")
#elif defined(__MK64FX512__)
#define BOARD F("Teensy 3.5")
#elif defined(__MK66FX1M0__)
#define BOARD F("Teensy 3.6")
#else
#define BOARD F("Unknown Board")
#endif
#else  // --------------- Arduino ------------------
#if defined(ARDUINO_AVR_ADK)
#define BOARD F("Arduino Mega Adk")
#elif defined(ARDUINO_AVR_BT)  // Bluetooth
#define BOARD F("Arduino Bt")
#elif defined(ARDUINO_AVR_DUEMILANOVE)
#define BOARD F("Arduino Duemilanove")
#elif defined(ARDUINO_AVR_ESPLORA)
#define BOARD F("Arduino Esplora")
#elif defined(ARDUINO_AVR_ETHERNET)
#define BOARD F("Arduino Ethernet")
#elif defined(ARDUINO_AVR_FIO)
#define BOARD F("Arduino Fio")
#elif defined(ARDUINO_AVR_GEMMA)
#define BOARD F("Arduino Gemma")
#elif defined(ARDUINO_AVR_LEONARDO)
#define BOARD F("Arduino Leonardo")
#elif defined(ARDUINO_AVR_LILYPAD)
#define BOARD F("Arduino Lilypad")
#elif defined(ARDUINO_AVR_LILYPAD_USB)
#define BOARD F("Arduino Lilypad Usb")
#elif defined(ARDUINO_AVR_MEGA)
#define BOARD F("Arduino Mega")
#elif defined(ARDUINO_AVR_MEGA2560)
#define BOARD F("Arduino Mega 2560")
#elif defined(ARDUINO_AVR_MICRO)
#define BOARD F("Arduino Micro")
#elif defined(ARDUINO_AVR_MINI)
#define BOARD F("Arduino Mini")
#elif defined(ARDUINO_AVR_NANO)
#define BOARD F("Arduino Nano")
#elif defined(ARDUINO_AVR_NG)
#define BOARD F("Arduino NG")
#elif defined(ARDUINO_AVR_PRO)
#define BOARD F("Arduino Pro")
#elif defined(ARDUINO_AVR_ROBOT_CONTROL)
#define BOARD F("Arduino Robot Ctrl")
#elif defined(ARDUINO_AVR_ROBOT_MOTOR)
#define BOARD F("Arduino Robot Motor")
#elif defined(ARDUINO_AVR_UNO)
#define BOARD F("Arduino Uno")
#elif defined(ARDUINO_AVR_YUN)
#define BOARD F("Arduino Yun")

// These boards must be installed separately:
#elif defined(ARDUINO_SAM_DUE)
#define BOARD F("Arduino Due")
#elif defined(ARDUINO_SAMD_ZERO)
#define BOARD F("Arduino Zero")
#elif defined(ARDUINO_ARC32_TOOLS)
#define BOARD F("Arduino 101")
#else
#define BOARD F("Unknown Board")
#endif
#endif
