budulinek/arduino-modbus-rtu-tcp-gateway/(commit log)

2021-03-31 Improved compatibility
    External libraries have been replaced to improve compatibility. Sketch is now compatible with Arduino Nano, Uno and Mega. Ethernet chips W5100, W5200 and W5500.
    [01-interfaces.ino, 02-modbus-tcp.ino, 03-modbus-rtu.ino, 04-webserver.ino, 05-pages.ino, arduino-modbus-rtu-tcp-gateway.ino]
2021-06-06 Fix timeout issue
    Fix timeout issue during TCP connection.
    [02-modbus-tcp.ino, 03-modbus-rtu.ino, 04-webserver.ino, 05-pages.ino]
2021-06-06 support hardware automatic flow control
2021-06-06 support automated flow control
2021-06-06 Bugfix reload config
    Fix crash after changes do webinterface config.
    [05-pages.ino]
2021-09-10 Fix issue #7 (Lost connection and Arduino freeze after few hours)
    Fix #7
    [05-pages.ino]
2021-10-15 Add SW version
    Add SW version to current status page. Forced factory reset (load defaut settings from sketch) on MAJOR version change.
    [04-webserver.ino, 05-pages.ino, arduino-modbus-rtu-tcp-gateway.ino]
2022-01-28 Code optimization, bugfix DHCP settings.
    [04-webserver.ino, 05-pages.ino, arduino-modbus-rtu-tcp-gateway.ino]
2022-12-02 Set MX_SOCK_NUM to 8
    Set maximum sockets to 8 as default. Set 4 sockets for W5200.
2022-12-04 Modbus slave errors in web ui
    [01-interfaces.ino, 02-modbus-tcp.ino, 03-modbus-rtu.ino, 04-webserver.ino, 05-pages.ino]
2022-12-04 Modbus stats
    Modbus stats and error reporting on "Current Status" page.
    [01-interfaces.ino, 02-modbus-tcp.ino, 03-modbus-rtu.ino, 04-webserver.ino, 05-pages.ino, arduino-modbus-rtu-tcp-gateway.ino]
2022-12-14 Serial line state machine, timers
2023-02-27 Improve board detection.
2023-03-04 Save error counters to EEPROM
    [01-interfaces.ino, 02-modbus-tcp.ino, 03-modbus-rtu.ino, 04-webserver.ino, 05-pages.ino, arduino-modbus-rtu-tcp-gateway.ino]
2023-09-21 Disable DHCP renewal fallback, recover after short power loss
    [01-interfaces.ino, advanced_settings.h, arduino-modbus-rtu-tcp-gateway.ino]
2023-10-20 set functionality based on Arduino board
2024-01-15 Bugfix Modbus RTU Request form, code comments
    [01-interfaces.ino, 02-modbus-tcp.ino, 04-webserver.ino, 05-pages.ino, arduino-modbus-rtu-tcp-gateway.ino]
2024-12-15 Readme, ethernet SW reset
    [arduino-modbus-rtu-tcp-gateway.ino]
2025-02-12 Fix compiler warning
    arduino-modbus-rtu-tcp-gateway/advanced_settings.h:69:50: warning: multi-line comment [-Wcomment]
    [advanced_settings.h]
2025-02-12 Move board definition to its own header, fixes BOARD redefined warning
    [01-interfaces.ino, advanced_settings.h]
2025-02-12 Change Microcontroller for Board in the system info page
2025-03-09 Fix 404 error page
    [04-webserver.ino, 05-pages.ino, arduino-modbus-rtu-tcp-gateway.ino]
2025-03-09 Revert "WEB: Move extended fields run time, eth data and rtu data to system info"
    This reverts commit 014260541c9df81999ab0b3d7a24fc7840e694d0.
    [05-pages.ino]
2025-03-09 Revert "Move board definition to its own header, fixes BOARD redefined warning"
    This reverts commit 70a1c508d0b992cc03e3ce8dc7735be45ba9db31.
    [01-interfaces.ino, advanced_settings.h]
